koorayworks/torabo-swingarm/README.md

# torabo-swingarm

Nape（menbou0202 氏のトラックボール設計）をベースにした、自作用トラックボール
ケースの設計リポジトリ。ケースは build123d（Python）でパラメトリックに生成し、
STL はスクリプトから再生成する方針のため、**正本はスクリプト**とする。

## 路線は2つ

- **Nape Deck（固定式・ディスプレイ付き）**: ESB 受信機＋ST7789 タッチ
  ディスプレイ付き。ファームは `zmk-config-esb-hid-test` の `esb_nape_rx`
  シールド側。ケースはこれから設計する。
- **無線ピボット版（このリポジトリの主対象）**: ディスプレイなし＋BLE 単体。
  ボールを中心に2本のアームが回る。現行は **v19**（印刷確認待ち）。

## 無線ピボット版 v19 の仕様

- 中央ユニット: 34mm ボール、センサーは TANBOKU（PAW3222 ブレークアウト）
- 細アーム（幅 24mm）×2本、2段カラーでピボット、各 2 キー縦並び（計4キー）
- 青ベゼルは回転式スクロールリング（裏面エンコーダスリット 24 本、
  反射型センサー×2 で直交検出）
- 右アーム首元に XIAO nRF52840、左アーム首元に電池 302030 級（約 300mAh）
- 配線は中央ユニット裏面の環状チャネル経由、JST-PH で着脱
- アーム先端の底に滑り止めパッド（Ø10mm 市販品）の埋め込み座 ×2/アーム

## バージョン履歴（scripts/ に対応）

| 版 | 内容 |
|---|---|
| v1 | 汎用スラブ形状の初期案（不採用） |
| v2 | オリジナルシルエット＋ディスプレイ、キー×3 |
| v3 | キー×2、TANBOKU を額縁リテーナでネジ止め |
| v4 | キーを弧上に配置、ディスプレイ＋XIAO はトップケース側 |
| v5 | ピボット機構に転換（中央ドラム＋カラー、配線リング） |
| v6 | カラーを2段バンド化、両アーム ±66° で横並び可能に |
| v7 | ディスプレイ横向き、配線リング復活 |
| v8 | ディスプレイ水平、キー 2×2 化 |
| v9 | 全周回転＋帽子断面リングで配線隠蔽（ピボット案の到達点） |
| v10 / v10d | 無線化の構成検討（A案: 片アーム集約 / D案: 台座） |
| v11 | C案（XIAO と電池を別アーム）、両アーム肩付き |
| v12 | リングを構造材（トラック）化、アーム短縮 |
| v13 | 電装をリング背面ポッドへ、アームはキーだけに |
| v14 | 細アーム（2キー）×4本の検討 |
| v15 | 細アーム×2本＋電装をアーム首元に内蔵（ミニC） |
| v16 | トラックリング廃止、配線は中央ユニット裏面経由 |
| v17 | スクロールリング追加、アームの余白を詰めた |
| v18 | 角度固定のセットスクリューボスを廃止（摩擦保持） |
| v19 | 滑り止めパッド（Ø10）の埋め込み座を追加（現行） |

## 公式 BallCase のバリエーション（25mm / 34mm段付き）

公式の BallCase（25mm ボール用、35×35）を土台にした別系統。

- **34mm 段付き**: 下部の首（35mm）は公式のまま残して Top ケースに
  そのまま嵌め、上で 44mm に広げて 34mm ボールを収める。
  - `build_ballcase_34_stepped_bs10.py`: ELECOM 交換用支持ユニットの
    受けポケット版（使うユニットは M-TU03SS。ソケット 8×7×4mm は
    M-BS10 / M-RS10 と共通。ファイル名の BS10 は旧称の名残）
  - ボール入口は Ø33.95（印刷確認済み: 逆さにしても抜けず、
    出し入れも軽い。Ø34.10 では抜け、Ø33.90 ではきつかった）
- **25mm CAD 版**（`build_ballcase_25_cad.py`）: 公式ケースを実測して
  CAD で作り直したもの。ボール面は解析球面 R13.25、上面は R8
  フィレット、センサー窓 Ø13 と底面の六角マグネット穴は公式位置どおり。
  支持ユニットポケット付き。

ポケット仕様（テストピースで決定、`build_bs10_coupon.py`）:
開口 8.0（接線方向）×7.7（壁方向）、深さは窪みの接平面から 3.35、
左右に全深さの逃げ溝 3.5×4.4、方位 0/120/240°、仰角 −26°。

## STL の生成

```sh
python3 -m venv .venv-cad
.venv-cad/bin/pip install build123d
.venv-cad/bin/python scripts/build_case_deck_v19.py   # deck19/ に STL 出力
.venv-cad/bin/python scripts/build_ballcase_34_stepped_bs10.py  # scripts/ballcase34/ に出力
.venv-cad/bin/python scripts/build_ballcase_25_cad.py           # scripts/ballcase25/ に出力
```

レンダーは `scripts/render_deck19.py`（matplotlib による簡易表示）。

ボールケースの生成済み STL / STEP は `ballcase34/` / `ballcase25/` にも
置いてある（STL はテキスト（ASCII）形式で保存。形状はバイナリ版と同一）。

## 前提寸法（未実測のものを含む）

- ディスプレイモジュール 31.5×39.0mm（Deck 案用、要ノギス確認）
- TANBOKU レンズ高さ = 基板上面から 3.4mm、ボール 34mm
- XIAO nRF52840: 21.0×17.8mm

## 関連

- 知見・経緯の記録: KeyboardBrain（プライベート）の Nape / Prospector Bridge ノート
- 構成検討の詳細: `docs/NapeWireless-config-study.md`
