koorayworks/torabo-swingarm/docs/NapeWireless-config-study.md

# 無線・稼働版 構成検討（2026-10-27）

ディスプレイなし＋ピボット稼働＋無線（BLE）版の構成メモ。
土台は試作ケース v9（ボール中心ピボット、2段カラー、配線リング）。

## 前提（本人決定）
- ディスプレイは付けない。その代わり**両アームとも 2×2 の正方形4キー**（計8キー）。
- 無線化する（バッテリー＋BLE、単体で完結するトラックボール）。
- 中央ユニットはボール＋TANBOKU のみ（v9 のまま流用できる）。

## 置き場所の制約（実寸から）
- **中央ユニットに XIAO は入らない**: Ø46 の中にレンズコーン（中心）とボール
  キャビティがあり、21×17.8mm の基板を平置きできる場所がない。立てても高さ不足。
  → マイコンはアーム側に置くしかない。
- アーム内部は厚さ 9mm（壁を除くと約6mm）→ 電池は厚さ 5mm 級のポーチセルまで。
  キーパッド（44×44）の下に 30×40mm 級が入る。
- XIAO nRF52840 は充電IC内蔵で、裏面パッドに電池を直結できる。USB-C は
  充電＋有線予備に使える（Deck 設計のアーム端 USB スロットがそのまま使える）。

## 配置の候補

### A案: 電装を片アームに集約（推奨）
- 片アーム（電装アーム）に XIAO＋電池（503040、約1000mAh、5×30×40mm）を
  キーパッド下に収納。もう片アームはキーのみ。
- 電源配線がピボットを越えない。越えるのは TANBOKU 線（6本、中央→電装アーム）と
  反対アームのキー線（3本）だけで、どちらも配線リングの下部チャネルを通る。
- 欠点: 電装アームだけ重くなる（約+25g）。アームは足で接地するので安定性は
  むしろ上がるが、左右の重量バランスは崩れる。

### C案: MCU と電池を別アームに分ける
- 重量バランスは良い。代わりに電池の電源線（2〜3本）がリングチャネル経由で
  ピボットを越える（チャネル内なので摩耗リスクは低いが、断線＝電源断になる）。

### D案: ベース一体で大容量
- 中央ユニット基部を拡げて大容量セル（2000mAh級）を内蔵する案。
  カラー帯の移動や配線リングの拡大が要る大改造で、ボール位置も上がりがち。
  電池持ち最優先なら候補だが、第一弾としては重い。

## ピン配分（XIAO、余裕あり）
- TANBOKU: D0（MOTION）/ D8（SCK）/ D9（CS）/ D10（SDIO）— Deck と同じ
- 電装アームのキー 2×2: チャーリープレックス 3本（D1/D2/D3）
- 反対アームのキー 2×2: チャーリープレックス 3本（D4/D5/D6）
- 余り: D7（電源LEDや追加キー用）
- ディスプレイとタッチが無い分、Deck で逼迫していたピンは解消する。

## 電池と運用の目安（推定）
- 503040（約1000mAh）: センサー＋BLE の消費から、日常使用で1〜3週間クラスが目安。
- 充電は XIAO 内蔵充電（USB-C）。充電電流は小さめなので、大容量セルでは
  充電時間は長めになる想定。
- 電源スイッチは電装アームに配置（電池＋線に直列のスライドスイッチが定番）。
- BLE アンテナ: XIAO のアンテナ端をアーム先端側に向け、電池（金属箔の塊）から
  離すのがレイアウトの鉄則。

## 決めること
- 電池とマイコンの配置: A案（集約）か C案（分離）か D案（ベース大容量）か。
- 電池サイズ: 503040（約1000mAh）か、薄さ優先で 402030（約400mAh）か。

## 決定（2026-10-27）
- D案はレンダーで確認して**不採用**（Ø110×8mm の台座が大きく、据え置き感が強すぎる）。
- **A案で確定**（→その後、同日に C案へ変更。下記「決定の変更」参照）: 電装アームに XIAO＋電池を集約。ケースは v10 として設計済み
  （`deck10/`）。電装アームは肩（電池 503040 を下に収納＋底カバー、その上に
  隔壁を挟んで XIAO＋上面カバー、USB はアーム外側面、電源スイッチ窓は内側面）
  ＋先端に 2×2 キーパッド。アーム厚は電装の積み重ねのため 12mm に変更。
  電装アームの到達長は 124mm、キー専用アームは従来通り 80mm で非対称。
- 未確認: XIAO のアンテナが内向き＋電池が近いので、BLE 感度は実機確認が要る。

## 決定の変更（2026-10-27、同日）
- 本人指示で **C案（XIAO と電池を別アーム）に変更**。理由: A案でも電装アームだけ
  長くなるなら、両アームに肩を作って分けた方がバランスが良い、という判断。
- ケースは v11 として設計済み（`deck11/`）: 両アームとも肩＋2×2 パッドで
  到達長 124mm に統一。右アーム肩に XIAO、左アーム肩に電池 503040。
- 電源線（2本）は配線リングの下部チャネル経由でピボットを越える。充電電流が
  小さいので細線で足りるが、電源線だけ少し太め（Ø0.8〜1.0）にする想定。
  組み立て順は「配線を通してからアームを組む」、電池のハンダは最後
  （またはスイッチ OFF）。アームを外せるようにしたい場合は JST-PH 等の
  コネクタを両端に挟むのが候補。

## v12: リングを構造材に（2026-10-27、本人のアイディア）
- 「アームが長いのはかっこ悪い」を受けて短縮（到達 124→111mm）。
  電池は 503030 級（30×30、目安800mAh）に小型化して左肩へ、XIAO は右肩へ（C案維持）。
- 配線リングを**構造材（トラック）に格上げ**: 外径 Ø103 に広げ、アーム裏面が
  リング上面に載って滑りながら回る形にした。支持はカラー＋リング面の2点に
  なり、先端の脚は廃止。安定感は中央ユニット＋リング全面接地で確保する。
  配線チャネルは従来通りリング内部（下部）に隠れる。
- **JST-PH コネクタ採用を決定**（本人承認）: 電源線など、ピボットを越える配線の
  両端に挟み、アームを外せるようにする。

## v13: 電装はリング背面のポッドへ（2026-10-27、本人の指摘）
- 「アームが長い、余白（肩）はいらない」を受けて、アームは v9 と同じ短い形
  （到達80mm、キーだけのパドル）に戻した。肩は電池と XIAO の置き場だったため、
  電装は**リング背面の固定ポッド**に移設: 64×17×高さ11.5mm に電池 503040 と
  XIAO を横並びで収納、USB と電源スイッチは背面に配置。ポッドの床から
  リング内チャネルへ直通させる想定。
- 配線はむしろ簡単に: ピボットを越えるのは各アームのキー線3本だけ
  （JST-PH で着脱）。TANBOKU 線は固定配線でポッドへ直行。
- 代償: ポッドのある背面側へはアームが回らない（使えるのは正面側 約260°）。
  C案（アーム分割）は終了し、電装はポッド集約に一本化。

## v13 のポッドは不採用（2026-10-27、本人）
- リング背面にポッドを持ってくる案は「なし」。アーム短縮は維持したい意向で、
  次の検討は「2キー縦並びのアーム ×4本」。電装（XIAO＋電池）の置き場は
  再び未決（アーム内・背面ポッドは不採用済み）。

## 確定: 2アーム × 2キー（2026-10-27、本人）
- アームは細型（幅24mm）×2本、各2キー縦並び（計4キー）で確定。4本案は不採用。
- 電装は「ミニC」として細アームの首元に内蔵する形に決定（v15）:
  右アーム首元に XIAO（底面ポケット＋カバー、USB は側面、電源スイッチ窓も側面）、
  左アーム首元に電池 302030 級（3×20×30mm、約300mAh、底面ポケット＋カバー）。
  肩スラブも背面ポッドも無し。アーム到達長は 94mm（v14 の細アーム 82mm から
  電装内蔵のため +12mm）。ピボットを越える線は電源2本＋左キー線で、
  JST-PH 着脱とする想定は維持。
- 電池容量が小さい（約300mAh）のがこの構成のコスト。ピンの実測クリアランスが
  取れれば 402030 級への拡大が候補。

## v16: リング廃止（2026-10-28、本人「リングかっこ悪い」）
- トラックリング（Ø103）を廃止。支持はカラー＋パッド下の脚に戻した。
- 配線は中央ユニットの裏面に環状チャネルを掘り、アーム根元で机面レベルまで
  潜らせてユニットの下で横断させる形に変更（リングなしでも配線は隠れる）。
  JST-PH 着脱の想定は維持。

## v17: スクロールリング＋アーム詰め（2026-10-28、本人発案＋指示）
- 青いベゼルを**回転式スクロールリング**化: ネジ止めを廃止し、裏面に
  エンコーダ用スリット 24 本を彫り、ドラム上面に反射型センサー2個の
  ポケット（33.75° 間隔＝2.25 ピッチで直交検出）を配置。ピン 2 本は
  キー4個をチャーリープレックス 3 本に集約して捻出する想定。
  リングの保持方法とクリック感（フリースピンか磁石デテントか）は印刷時に決める。
- アームの中心寄りの余白を詰めた: キー位置 58/77 → 46/65mm、
  到達長 94 → 82mm、中心側の余白は約 10mm に。電装ポケットは不変で、
  ピン先端との隙間は XIAO 上面 1.7mm／電池上面 1.4mm（モデル上の計算値）。

## 現行仕様（v17、2026-10-28 時点の到達点）
- 中央ユニット（34mm ボール、TANBOKU）＋細アーム（幅24mm）×2本が
  2段カラーでピボット。各アーム 2 キー縦並び（計4キー）、到達長 82mm。
- 青ベゼルは回転式スクロールリング（裏面スリット 24 本＋反射型センサー×2）。
- 電装: 右アーム首元に XIAO、左アーム首元に電池 302030 級。配線は
  中央ユニット裏面の環状チャネル経由、JST-PH 着脱。リング/ポッド/肩は無し。
- アームは 180° スイング可（相手のアームを追い越しは不可、連続 360° 回転は
  配線が巻き付くため不可）。
- 次の段階は印刷しての確認: カラーの動き、スクロールリングの回転、
  XIAO/電池ポケットとスイッチピンの隙間（モデル計算 1.7/1.4mm）の実測。

## v18: セットスクリューのボスを廃止（2026-10-28、本人の選択）
- 角度固定はカラーの摩擦＋脚の引きずりに任せ、ボスとねじ穴を削除。
  v5 の重いアーム時代の名残りだった。印刷して緩ければ、カラーの
  きつめ再印刷や摩擦材で対処する方針。

## v19: 滑り止めパッドの埋め込み座（2026-10-28、本人指示）
- アーム先端の印刷脚をやめ、底面に滑り止めパッドの座を追加:
  座ブロック（18×24×3mm）の底に Ø10.4 × 深さ 1.4mm の窪み ×2（左右方向）。
  ダイソー等で買える Ø10mm・厚さ約 2mm のパッドを貼ると約 0.6mm 出て接地する
  計算。パッドの厚みが違う場合は窪みの深さ（1パラメータ）で調整。
- 狙いは角度固定ではなく「置いたら動かない」こと。アームの角度保持は
  この接地摩擦も効く想定。

※ 現行は v19（上の「現行仕様（v17）」から、セットスクリューのボス廃止と
　滑り止めパッド座の追加が差分）。
