koorayworks/torabo-swingarm/ballcase25/Nape-BallCase-25mm-unitpockets-CAD.step

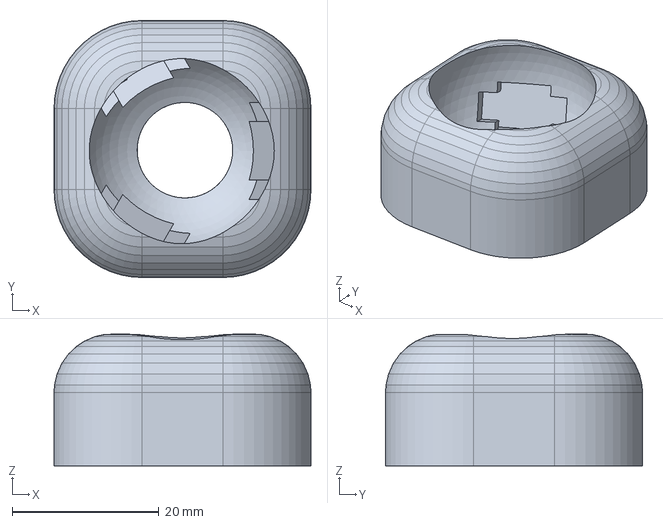
[picture p1: CAD file, 2026-11-03]
ballcase25/Nape-BallCase-25mm-unitpockets-CAD.step
35.0 x 35.0 x 18.0 mm
