koorayworks/torabo-swingarm/(list of files, cad)

Other CAD files:
ballcase25/Nape-BallCase-25mm-unitpockets-CAD.stl
ballcase34/Nape-BallCase-34mm-stepped-BS10.stl
