koorayworks/torabo-swingarm/(commit log)

2026-10-29 Initial commit: torabo-swingarm case design scripts (v1-v19), docs, README
2026-11-03 Add official BallCase variants: 34mm stepped (loose-ball / support-unit pockets) and 25mm CAD rebuild
2026-11-03 Add generated STL/STEP for 34mm stepped support-unit ball case (STL in ASCII form)
    [Nape-BallCase-34mm-stepped-BS10.step, Nape-BallCase-34mm-stepped-BS10.stl]
2026-11-03 Add generated STL/STEP for 25mm CAD ball case; note stored models in README
    [Nape-BallCase-25mm-unitpockets-CAD.step, Nape-BallCase-25mm-unitpockets-CAD.stl]
2026-11-03 Add generated STEP for 34mm stepped loose-ball ball case
    [Nape-BallCase-34mm-stepped.step]
2026-11-03 25mm ball case: pocket height 7.6 confirmed just right (7.7 loose); update default and stored models
    [Nape-BallCase-25mm-unitpockets-CAD.step, Nape-BallCase-25mm-unitpockets-CAD.stl]
2026-11-03 Remove the dia-6 loose-ball variant (not needed)
    [Nape-BallCase-34mm-stepped.step]
